ImmunoYao/MagCup4D/MagCup 4D_Outside.stl

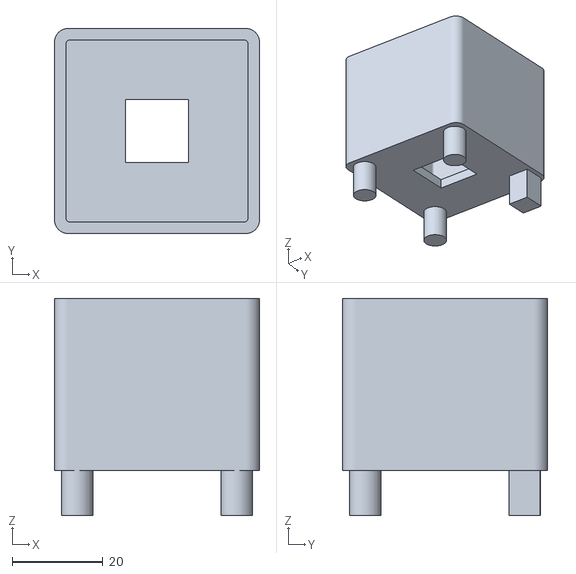
[picture p1: CAD file, 2026-11-11]
MagCup 4D_Outside.stl
45.3 x 45.3 x 48.0
