ImmunoYao/MagCup4D/装配与安全.md

# Mag-Cup 4D | Inside + Outside 装配和安全说明

本文件配套两件打印零件：**Inside（内衬）**、**Outside（底座外套）**；尺寸公差以各自 PDF 图纸为准。

## 打印要求

| 参数 | Inside | Outside |
| --- | --- | --- |
| 材料 | PETG | PETG |
| 层高 | 0.2 mm | 0.2 mm |
| 外壁 | 3 层 | 3 层 |
| 填充率 | ≥40% | ≥30% |
| 打印姿态 | 法兰朝上 | 杯口朝上 |
| 支撑 | 不加 | 不加 |

- Inside 的四条径向外侧开放磁铁槽是设计要求，不要把它们当成破面修补。
- 检查槽底最薄 0.5 mm 处有无透光、孔洞或裂纹。
- 钢管内腔及焊筋/圆角必须实测，打印件不应强行敲入。

## 外购材料

1. 镀锌导磁钢方管 40 × 40 × 4 mm，长度 30 mm；原型内腔实测约 32.0 mm。
2. N52 钕铁硼磁铁 30 × 10 × 10 mm，共四块，**沿 10 mm 厚度方向充磁**。
3. 适配的 1.5 mL / 2 mL EP 管。

## 组装顺序

1. 清除钢方管切口毛刺，确认导磁性、内腔尺寸及四角圆角半径。
2. 将 Inside 嵌入钢管，法兰稳固地落在上沿。
3. **装配前**用可靠的磁极测试方法标记每块磁铁：四块磁铁朝向中心管孔的面必须依次 **N / S / N / S**。
4. 从钢管**底部**将磁铁逐块推入开放槽，推进至上方法兰底面。使用木质或铝质推杆，严禁手指进入夹点。
5. 将钢管/磁铁/Inside 组件整体插入 Outside 杯腔。
6. 插入 EP 管检查轴向定位、间隙及机械稳定性。先用模拟样本测试再用于正式实验。

## 使用与清洁

磁分离所需时间由磁珠及试剂盒决定，不应仅凭磁架几何设定统一时间。倒转弃上清和吸取残液的手法应先做兼容性及样本损失验证。聚集区域与未聚集区域的实际位置取决于所用体系。

打印件不得默认可高压灭菌；如需使用 70% 乙醇擦拭，应检验材料与实际使用环境的相容性。定期检查磁铁槽、打印层间、钢管切口的锈蚀及磁铁位移。

**安全：** 强磁铁可能突然吸合、夹伤和崩裂，须佩戴护目镜和合适手套，远离对磁场敏感的仪器以及植入式医疗设备。本设计仅供科研，不作为医疗诊断设备。
