ImmunoYao/MagCup4D/设计原理与装配说明.md

# 自制四极细胞分选磁力架 — 设计存档

**设计结构** Inside（内衬）＋ Outside（底座外套）  
**用途** 1.5/2 mL EP 管、无柱式（column-free）磁性细胞分选，替代商品化管式磁架  
**实验记录** 内部试验使用商品化分选 kit，报告纯度达标；尚未附原始验证数据

---

## 1. 结论与定位

这套磁架替代的是**磁架硬件**，不是试剂。实测结论：

- 原始内部记录报告：配商品化 column-free 分选 kit，分选纯度与原厂磁架相当（仓库尚未公开原始数据）
- 结构为四极 + 钢轭，场型优于常见的单侧磁条式通用磁力架

> 自配生物素抗体 + IP 用链霉亲和素磁珠的路线未跑通（非特异污染严重），但该问题出在标记与磁珠端，与本磁架无关。相关内容不在本文档范围。

---

## 2. 工作原理

### 2.1 决定分选效果的是梯度，不是场强

磁珠在 0.1–0.3 T 左右即磁饱和，此后受力

```
F ≈ m_sat · ∇B
```

只取决于**梯度**。因此设计上的一切取舍都指向"让磁铁尽可能贴近管壁"，而不是"堆更强的磁铁"。N48 与 N52 的剩磁只差约 5%，从来不是瓶颈；几何才是。

### 2.2 为什么是四极

| 构型 | 管内最弱位置 | 说明 |
|---|---|---|
| 单侧磁条（通用磁力架） | 对侧管壁，距磁铁约 10 mm，场强降至 0.05–0.1 T，珠未饱和且梯度低 | 弱区拉力最小，细胞最容易漏抓 |
| 四极 | 管中心，场强≈0，但细胞只需移动 2–5 mm 即进入强梯度区 | 四条聚集带，分摊后每条更薄、贴壁更牢 |

四极另有一个操作上的好处：四条聚集带位于 0°/90°/180°/270°，**两带之间的 45° 方位相对干净**，补吸残液时从该方位下吸头可最大限度避免扰动贴壁细胞。

### 2.3 磁轭的双重作用

外侧钢管既是磁路的闭合回路（提升管壁处场强），又是结构件——四块磁铁被钢管吸向外壁，抵消了它们彼此相吸的力，使位置自锁。**没有钢轭的纯打印版本，磁铁会持续挤压塑料隔壁并长期蠕变。**

---

## 3. 最终规格（Inside / Outside）

### 3.1 尺寸链（核心）

整条链由**钢管内腔**唯一确定：

```
钢管内腔 32.0（实测）
  → 内腔半宽 16.0
  → 磁铁厚 10.0，磁铁内面落在半径 6.0
  → 中心孔半径 5.5（Ø11.0）
  → 槽底壁厚 0.5
```

磁铁内面距 EP 管壁仅 **0.6 mm**。

### 3.2 零件清单

| 件 | 规格 | 数量 | 备注 |
|---|---|---|---|
| 镀锌方管 | 40×40×4，长 30 | 1 | 磁轭 + 骨架。实测外形 40.0、内腔 32.0、内圆角 ≈R4 |
| 钕磁铁 | N52 30×10×10，**厚度方向充磁** | 4 | 交替极性。整包 10 个，余作备件 |
| 内衬 | PETG 打印，`MagCup 4D_Inside.stl` | 2 | 备一件（槽底 0.5 mm 有打印风险） |
| 底座外套一体杯 | PETG 打印，`MagCup 4D_Outside.stl` | 1 | 含脚、底板、外套 |
| 耗材 | 1.5/2 mL EP 管（Ø10.8） | — | 靠凸缘挂在内衬法兰上 |

### 3.3 Inside（内衬）

| 项 | 值 | 公差 |
|---|---|---|
| 外形 | 31.8 × 31.8，四角 **R5** | 0 / −0.15 |
| 中心孔 | Ø11.0 通孔 | +0.15 / −0 |
| 磁铁槽 | 10.3 宽 × 径向外侧敞开，四条十字对称 | +0.15 / −0 |
| 槽底半径 | 6.0（自中心量） | ±0.1 |
| 槽底壁厚 | 0.5（最薄处） | 不得破洞 |
| 主体高 | 30.0 | ±0.2 |
| 法兰 | 40 × 40 × 3，封死槽上端 | — |
| 总高 | 33.0 | ±0.2 |
| 实体体积 | 19.1 cm³ | 3 层壁 40% 填充约耗丝 16–18 g |

外角取 R5 而非 R4，比钢管内圆角更圆，可容纳实测 3.5–4.5 的圆角波动，**省掉一次测量**。

### 3.4 Outside（底座外套一体杯）

| 项 | 值 | 公差 |
|---|---|---|
| 外形 | 45.3 × 45.3 | ±0.3 |
| 杯腔 | 40.3 × 40.3（配钢管外形 40.0 + 0.3 间隙） | +0.2 / −0 |
| 杯腔深 | 35.0（钢管长 30 + 围边 5） | +0.3 / −0 |
| 底板厚 | 3.0 | — |
| 中央开口 | 14 × 14（管尖穿出 / 观察 / 排液 / 兜住磁铁下端） | ±0.2 |
| 脚 | 高 10，一方（7×7，方位记号）三圆（Ø7） | ±0.3 |
| 壁厚 | 2.5 | ≥ |
| 总高 | 48.0 | ±0.3 |
| 实体体积 | 21.9 cm³ | 3 层壁 30% 填充约耗丝 16–18 g |

### 3.5 装配后高度链

| 位置 | 离桌面 |
|---|---|
| 脚底（桌面） | 0 |
| 底板上表面 / 杯腔底 | 13 |
| 钢管顶 / 内衬法兰底 | 43 |
| 内衬法兰顶（EP 管凸缘落座面） | 46 |
| 杯口 | 48 |
| **EP 管锥尖** | **7.5** |

管尖从底板开口穿出，蹲下从侧下方可直视，判断上清是否吸净。

### 3.6 打印要求

- 材料 **PETG**（不可用 PLA — 成品需长期 70% 乙醇擦拭）
- 层高 0.2 mm｜外壁 3 层｜内衬填充 ≥40%、杯 ≥30%｜**不加支撑**
- 摆放：内衬法兰朝上、杯口朝上，均沿高度方向竖直打印
- 内衬四条槽径向外侧为**敞开面**，属设计要求，非建模缺陷（需在下单时写明，否则打印店会以为模型损坏）
- 槽上端由法兰封死、下端全开，**不得反向摆放**
- 收到件对光检查四条槽底 0.5 mm 处有无透光破洞

---

## 4. 装配

### 4.1 顺序

1. 内衬塞入钢管，法兰坐实钢管顶口
2. 四块磁铁**从底部**逐块推入，顶到法兰底面（用木质或铝质推杆，**不可用铁质**）
3. 整根钢管坐入一体杯杯腔
4. EP 管从中心插入，凸缘挂在内衬法兰上

磁铁被钢管吸向外壁、内面落在 0.5 mm 槽底，位置自锁，不需要灌胶。

### 4.2 极性（唯一不能凑合的一步）

四块磁铁**朝内的面必须交替 N/S**。

装配前先标记：取第五块磁铁，去试每块的同一面，吸的记 N、斥的记 S，贴美纹纸写上，确认无误再装。**装反一块，四极场就垮了，而且装进去后取不出来。**

### 4.3 安全

- N52 是烧结体，脆如陶瓷，边角受力即崩（本项目已崩过一块）
- 磁铁在最后几毫米会自行加速吸合，推杆的作用是**控制**这个过程，不是发力推进
- 全程戴手套，手指不得置于两块磁铁之间、或磁铁与钢管壁之间
- 远离硬盘、门禁卡、精密天平、植入式心脏装置

---

## 5. 使用

1. EP 管装样，**扣上盖**
2. 插入磁架，静置（时间按所用磁珠滴定）
3. **拇指压住管盖，连管带架一次性快速翻转**倒出上清（慢转会让液流冲下已贴壁的细胞）
4. 倒扣位停 2–3 秒滴净，直接翻正，**中途不回摇、不甩**
5. **管子不离开磁架**，用移液器补吸锥部残液——吸头从**两条聚集带之间的 45° 方位**下去，贴中心轴慢走
6. 阳选需在原位加缓冲液重悬、再静置、再弃，洗 1–2 遍

从底板开口可随时确认锥尖是否吸净。

> 注：正选与负选都应把上清弃净/收净 —— 正选时残留上清是污染源，负选时上清本身就是产物。

---

## 6. 维护

- 仅用 **70% 乙醇擦拭**；不浸泡、不高压灭菌、不接触次氯酸钠
- 热镀锌层为牺牲阳极保护，日常防锈已足够，**不需额外刷环氧**
- 例外：钢管两个**切口端面是裸铁**，建议用环氧或指甲油薄封
- N52 工作温度上限约 80 °C，任何加热灭菌都会退磁
- 定期检查：中心孔有无划伤、槽底 0.5 mm 处有无破损、磁铁有无位移

---

## 7. 选型规则（换钢管时重新推导用）

全部由钢管内腔 `C` 出发：

| 项 | 公式 | 本例（C = 32.0） |
|---|---|---|
| 磁铁厚 | `C/2 − 6.0` | 10.0 |
| 磁铁宽 + 厚 | `≤ 27`（保证外角避开内腔 R 圆角） | 10 + 10 = 20 ✓ |
| 磁铁长 | 30（覆盖液柱） | 30 |
| 内衬外形 | `C − 0.2`，四角 R5 | 31.8 |
| 槽底半径 | 6.0（固定） | 6.0 |
| 中心孔 | Ø11.0（固定，配 EP 管 Ø10.8） | Ø11.0 |
| 槽底壁厚 | `6.0 − 5.5` | 0.5 |
| 杯腔 | 钢管实测外形 + 0.3 | 40.3 |

**约束**：`C/2 − 6.0 ≥ 4`，即内腔不得小于 20；`C` 过大则磁铁需加厚，成本与重量上升。内腔 32–36 是这套几何的舒适区。

---

## 8. 设计演进与踩过的坑

存档重点。以下每一条都是实际付出代价换来的。

### 8.1 原理层面

- **带孔磁环（打孔/沉头孔圆片）不可用**。径向充磁环的孔内是**均匀场**，∇B≈0，磁珠不受力；轴向充磁环孔内中段磁场相消，梯度只在孔口端面几毫米。"整块打个孔"这个直觉是错的。
- **烧结钕铁硼不能自行加工**。硬脆（HV 550–650），钻孔必崩边，切削发热 >80 °C 即退磁，粉末细屑会自燃。厂家流程是"压制烧结→金刚石磨削→最后充磁"，顺序不可倒。
- **异极相对 = 均匀场 = 无效**。两块磁铁对着放时，必须是**同极相对**（互斥）才产生梯度。

### 8.2 材料层面

- **304 / 201 / 316 不锈钢无磁，绝对不能做磁轭**。需铁素体：430（最佳）、409（可用但耐蚀弱，本为排气管钢种）、或碳钢/镀锌钢（磁性最好，Bs 2.1 T）。
- 验货十秒法：**拿小磁铁吸一下**，吸得住才是对的。
- **热镀锌 vs 电镀锌**：热镀锌层厚 40–80 µm，防锈更好但内腔尺寸缩小、可能有锌瘤。本例内腔仅留 0.2 mm 间隙，务必**实测内腔而非采信标称**。
- 冷弯方管特征：**内壁有一道纵向焊筋**（内毛刺，高 0.3–0.8 mm，可导致内衬塞不进，需锉平）；**内圆角半径 ≈ 壁厚**（本例 R4，直角内衬会被四角顶住）。

### 8.3 尺寸层面

- **壁厚决定一切**。40×40 方管：3 mm 壁→内腔 34（最平衡）；3.5 mm→33（原设计）；**4 mm→32（本例，10 mm 磁铁勉强，曾因硬挤导致磁铁崩角）**；5 mm→30（装不下）。
- **磁铁宽度决定能否避开内腔圆角**。20 mm 宽的磁铁风车排布后外角会撞进 R4 圆角（干涉近 1 mm），**改用 10 mm 宽后可正十字排布，外角全落在平直段**，且极面总面积不变（4×30×10 = 2×30×20 = 1200 mm²）——这是本项目最关键的一次修正。
- **量内腔要避开四角圆弧**，卡尺爪落在平直段中部；两个方向各量一次取小值。

### 8.4 管型演进

由 5 mL 圆底管改为 2 mL EP 管，带来三个附加收益：

- EP 管**凸缘自带轴向定位**，省掉 O 圈/卡爪/锥度等一切保持机构
- **管盖 + 拇指压住即可倒扣**，比 O 圈更可靠，且气溶胶风险更低
- 管径更小 → 磁铁离管壁更近 → 梯度更高

代价：装载上限约 1.2–1.5 mL；PS（5 mL 管）与 PP（EP 管）表面性质不同，非特异贴壁行为可能有差异，首次使用建议平行比对。

### 8.5 结构层面

- **内衬不可省**。它同时承担磁极间隔（防止相邻磁铁合拢短路磁通）、装配通道、管子定位三项功能，成本仅几克 PETG，是全套性价比最高的零件。
- **磁铁必须靠刚性结构隔离**，胶带只能防滑不能防吸。
- **底座与外套一体成型优于分体**：分体会在底板与外套之间留一道正对管尖的缝，积液且易错位。
- **杯壁要高出钢管顶约 5 mm**（早期结构与钢管齐平，内衬法兰曾裸露在外）。通则：这类包裹件宁可做长，长了可以手工锉短，短了只能重打。

---

## 9. 后续可选改进

- **换 40×40×3 方管**（内腔 34）：中心孔壁厚由 0.5 增至 1.25，打印可靠性显著提升，磁铁仍用 10 mm 厚。若需重打，优先走这条。
- **多管/96 孔批量版**：钢管换为整块低碳钢板铣通孔阵列，磁铁规格与本尺寸链可直接复用；此时倒扣手法不再成立，需改为顶部压板保持。
- **更大体积**：若需跑 >1.5 mL，磁铁改回 30 → 40 mm 长，钢管与两个打印件的高度同步加长。
