ImmunoYao/MagCup4D/(commit log)

2026-11-11 docs: add clearly versioned v3 reference BOM
    [BOM_v3_reference.csv]
2026-11-11 docs: add v3-only assembly and printing reference
2026-11-11 docs: add final Inside and Outside parts documentation
    [BOM.csv]
2026-11-11 chore: replace legacy versioned files with final Inside/Outside naming
    [BOM_v3_reference.csv, MagCup 4D_Outside.stl]
